mcer12/Ambien-ESP32/images/image2.jpg

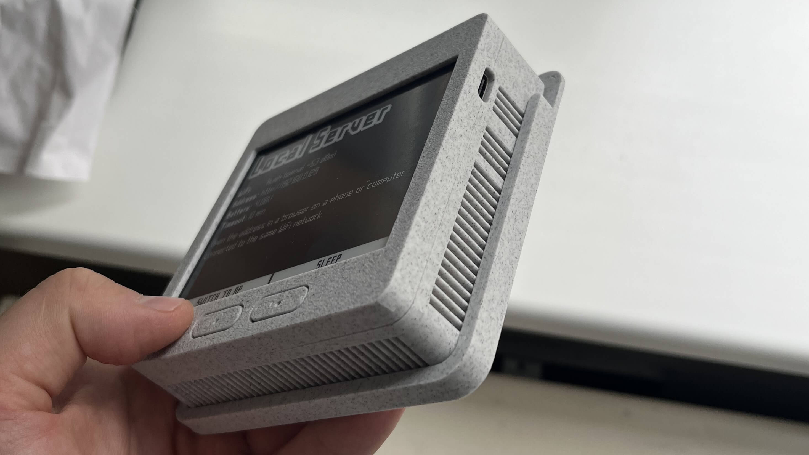
images/image2.jpg
