mcer12/Ambien-ESP32/images/portal_dark.png

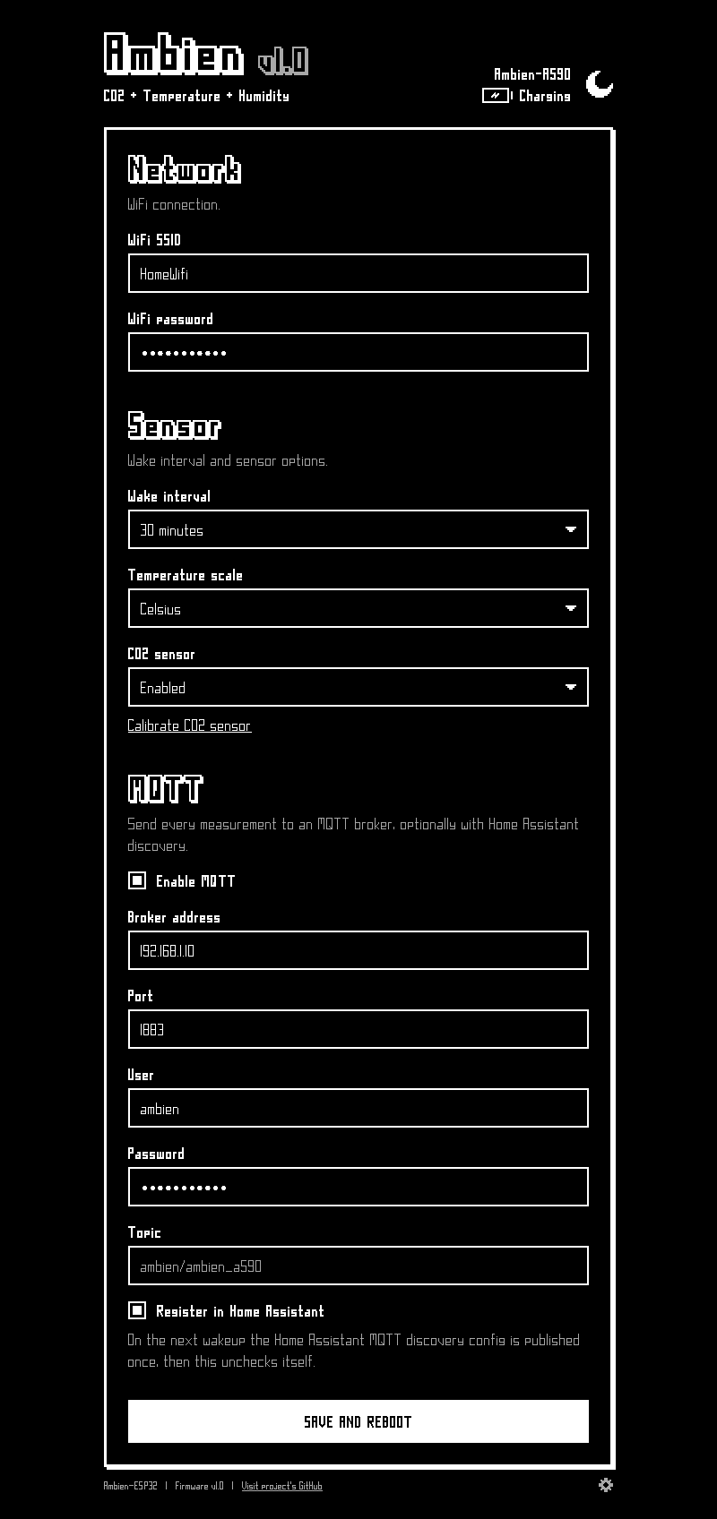
images/portal_dark.png
