mcer12/Ambien-ESP32/images/screen_ap.png

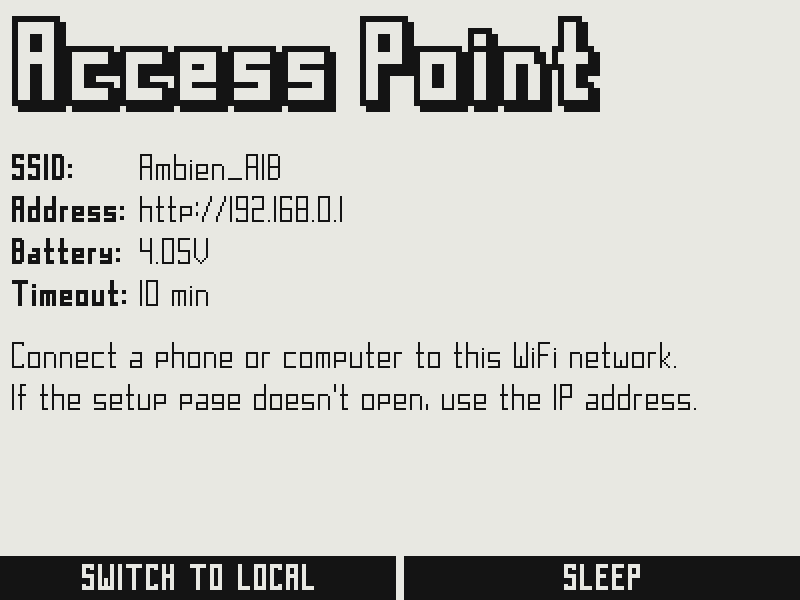
images/screen_ap.png
