mcer12/Ambien-ESP32/images/screen_no_co2.png

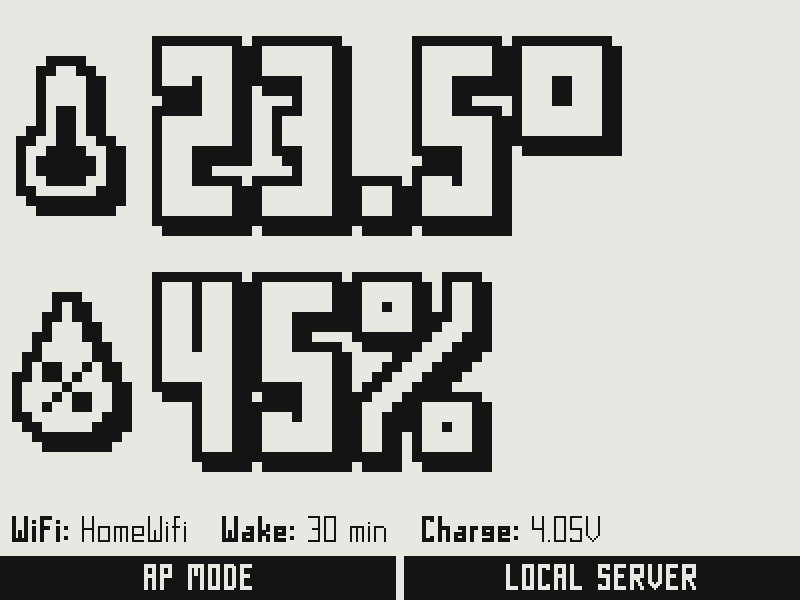
images/screen_no_co2.png
