mcer12/Ambien-ESP32/images/screen_sensors.png

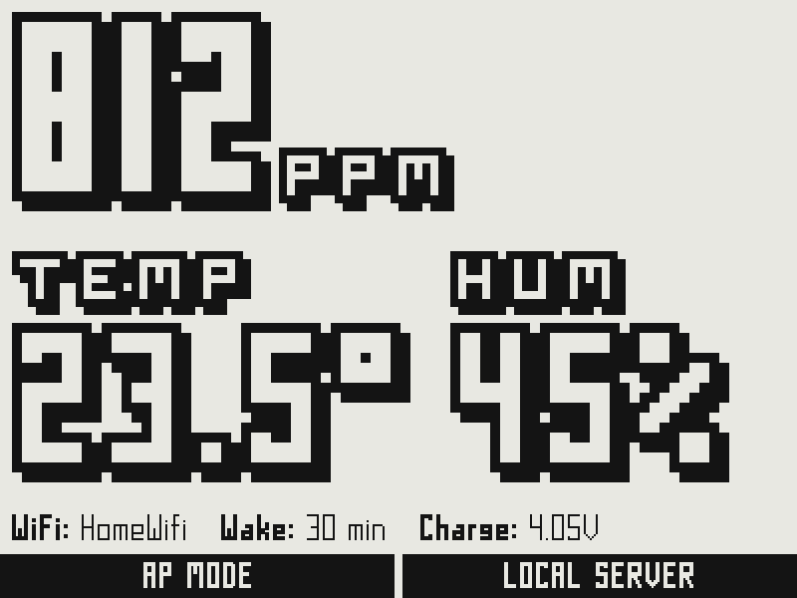
images/screen_sensors.png
