mcer12/Ambien-ESP32/pcb/Ambien_1.0_BOM.csv

ID | Name | Designator | Footprint | Quantity | Manufacturer Part | Manufacturer | Supplier | Supplier Part | Price
1 | KT-0603R | CHRG1 | LED0603-R-RD | 1 | KT-0603R | KENTO | LCSC | C2286 | 0.008
2 | 19-217/GHC-YR1S2/3T | FULL1 | LED0603-R-RD | 1 | 19-217/GHC-YR1S2/3T | EVERLIGHT | LCSC | C72043 | 0.024
3 | 680uF | C1 | CAP-SMD_BD6.3-L6.6-W6.6-LS7.2-FD | 1 | EEEFTJ681XAP | PANASONIC(松下) | LCSC | C178602 | 0.487
4 | 100nF | C19,C23,C5,C24,C25 | C0603 | 5 | CC0603KRX7R9BB104 | YAGEO(国巨) | LCSC | C14663 | 0.014
5 | 1uF | C2,C6,C7,C8,C9,C10,C11,C12,C13 | C0603 | 9 | CL10A105KB8NNNC | SAMSUNG(三星) | LCSC | C15849 | 0.016
6 | 4.7uF | C3 | C1206 | 1 | CS3216X7R475K500NRI | SAMWHA(三和) | LCSC | C513768 | 0.158
7 | 10uF | C4,C14,C15,C17,C18 | C0603 | 5 | CL10A106KP8NNNC | SAMSUNG(三星) | LCSC | C19702 | 0.031
8 | 5.1K | R1,R15 | R0603 | 2 | 0603WAF5101T5E | UNI-ROYAL(厚声) | LCSC | C23186 | 0.002
9 | 10K | R9,R3 | R0603 | 2 | 0603WAF1002T5E | UNI-ROYAL(厚声) | LCSC | C25804 | 0.005
10 | 6.8K | R10 | R0603 | 1 | 0603WAF6801T5E | UNI-ROYAL(厚声) | LCSC | C23212 | 0.002
11 | 2.2K | R12 | R0603 | 1 | 0603WAF2201T5E | UNI-ROYAL(厚声) | LCSC | C4190 | 0.002
12 | 1K | R13 | R0603 | 1 | 0603WAF1001T5E | UNI-ROYAL(厚声) | LCSC | C21190 | 0.002
13 | 1kΩ | R21 | R0603 | 1 | 0603WAF1001T5E | UNI-ROYAL(厚声) | LCSC | C21190 | 0.002
14 | 100Ω | R22 | R0603 | 1 | 0603WAF1000T5E | UNI-ROYAL(厚声) | LCSC | C22775 | 0.003
15 | 3 | R2 | R0603 | 1 | 0603WAF300KT5E | UNI-ROYAL(厚声) | LCSC | C23157 | 0.004
16 | 470uF | C20 | CASE-D_7343 | 1 | TAJD477K006RNJ | Kyocera AVX | LCSC | C7229 | 1.272
17 | BATTERY-18650 | BAT1,BAT2 | 18650_SMD | 2
18 | 1uF | C27,C28 | C0603 | 2 | CL10A106KP8NNNC | SAMSUNG | LCSC | C19702 | 0.031
19 | B5819WS | D1,D2,D3 | SOD-323_L1.8-W1.3-LS2.5-RD | 3 | B5819WS | MDD | LCSC | C64886 | 0.025
20 | SS34_C8678 | D4,D5 | DO-214AC_L4.3-W2.7-LS5.3-RD | 2 | SS34 | MDD | LCSC | C8678 | 0.035
21 | JFC0603-1100FS | F1,F2 | F0603 | 2 | JFC0603-1100FS | JDTFUSE | LCSC | C136329 | 0.066
22 | MF-PSMF110X-2 | F5 | F0805 | 1 | MF-PSMF110X-2 | BOURNS | LCSC | C89658 | 0.052
23 | AO3401A | F8 | SOT-23_L2.9-W1.3-P1.90-LS2.4-BR | 1 | AO3401A | AOS | LCSC | C15127 | 0.103
24 | AFC07-S24ECA-00 | FPC1 | FPC-SMD_AFC07-S24ECA-00 | 1 | AFC07-S24ECA-00 | JUSHUO | LCSC | C262643 | 0.134
25 | XC6206P332MR | LDO2 | SOT-23-3_L2.9-W1.6-P1.90-LS2.8-BR | 1 | XC6206P332MR | TOREX | LCSC | C5446 | 0.144
26 | SI1308EDL-T1-GE3 | Q2 | SOT-323_L2.0-W1.3-P1.30-LS2.1-BR | 1 | SI1308EDL-T1-GE3 | VISHAY(威世) | LCSC | C469327 | 0.29
27 | FS8205 | Q3 | SOT-23-6_L2.9-W1.6-P0.95-LS2.8-BR | 1 | FS8205 | FORTUNE | LCSC | C32254 | 0.183
28 | 10K | R4,R5 | R0603 | 2 | 0603WAF1002T5E | UniOhm | LCSC | C25804 | 0.005
29 | 1K | R6,R7 | R0603 | 2 | 0603WAF1001T5E | UniOhm | LCSC | C21190 | 0.002
30 | 10kΩ | R8,R11,R18,R19,R20 | R0603 | 5 | 0603WAF1002T5E | UniOhm | LCSC | C25804 | 0.005
31 | 680kΩ | R23,R24 | R0603 | 2 | 0603WAF6803T5E | UniOhm | LCSC | C25822 | 0.002
32 | MMBT3904-C20526 | T1,T2 | SOT-23-3_L2.9-W1.3-P1.90-LS2.4-BR | 2 | MMBT3904 | CJ | LCSC | C20526 | 0.012
33 | FS312F-G | U1 | SOT-23-6_L2.9-W1.6-P0.95-LS2.8-BR | 1 | FS312F-G | FORTUNE | LCSC | C82736 | 0.143
34 | SHT30-DIS-B | U2 | DFN-8_L2.5-W2.5-P0.50-BL-EP | 1 | SHT30-DIS-B | Sensirion | LCSC | C77361
35 | USBLC6-2SC6_C323793 | U4 | SOT-23-6_L2.9-W1.6-P0.95-LS2.8-BL | 1 | USBLC6-2SC6 | Yenji Elec | LCSC | C323793
36 | CH340C | U7 | SOP-16_L10.0-W3.9-P1.27-LS6.0-BL | 1 | CH340C | WCH | LCSC | C84681 | 0.548
37 | ESP-WROOM-32 | U8 | WIFIM-SMD_ESP-WROOM-32 | 1 | ESP-WROOM-32 | ESPRESSIF | LCSC | C95209
38 | USB3.1C16PFSMT | USBC1 | USB-C-SMD_TYPE-C-USB-17 | 1 | - | LCSC | LCSC | C167321 | 0.397
39 | 10uH | L1 | IND-SMD_L4.0-W4.0 | 1 | CR4030-100M | ceaiya(柯爱亚) | LCSC | C520323 | 0.048
40 | SCD40/SCD41 MODULE COPY | U5 | SCD40/SCD41 MODULE | 1
41 | HT7833_C164106 | U6 | SOT-23-5_L3.0-W1.7-P0.95-LS2.8-BR | 1 | HT7833 | Holtek Semicon | LCSC | C164106 | 0.34
42 | TP4059 | U3 | SOT-23-6_L2.9-W1.6-P0.95-LS2.8-BR | 1 | TP4059 | TOPPOWER(南京拓微) | LCSC | C80364 | 0.125
43 | pushbutton | B1,B2 | SW-SMD_L3.9-W3.0-P4.45 | 2 | TS-1088R-02026 | XUNPU | LCSC | C455280 | 0.056
