mcer12/Ambien-ESP32/enclosure/co2_top.3mf

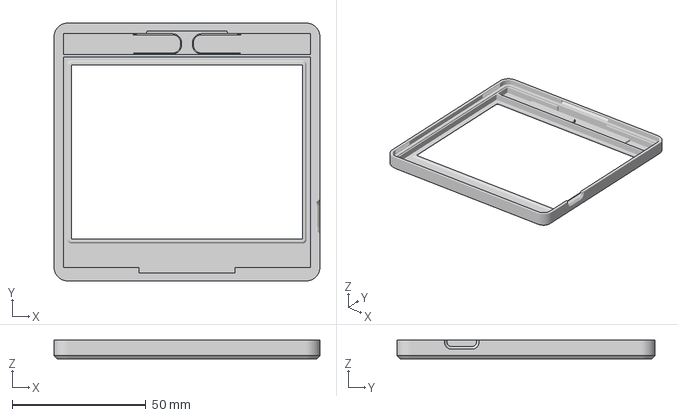
[picture p8: CAD file, 2026-10-29]
enclosure/co2_top.3mf
99.4 x 96.4 x 7.00 mm
