mcer12/Ambien-ESP32/enclosure/co2_holder.3mf

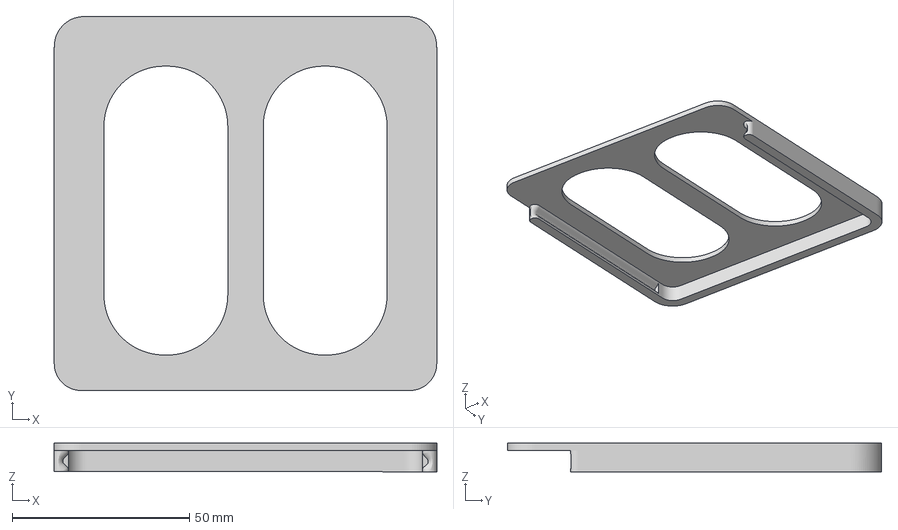
[picture p9: CAD file, 2026-10-29]
enclosure/co2_holder.3mf
107.8 x 105.4 x 8.03 mm
