mcer12/Ambien-ESP32/enclosure/co2_bottom.3mf

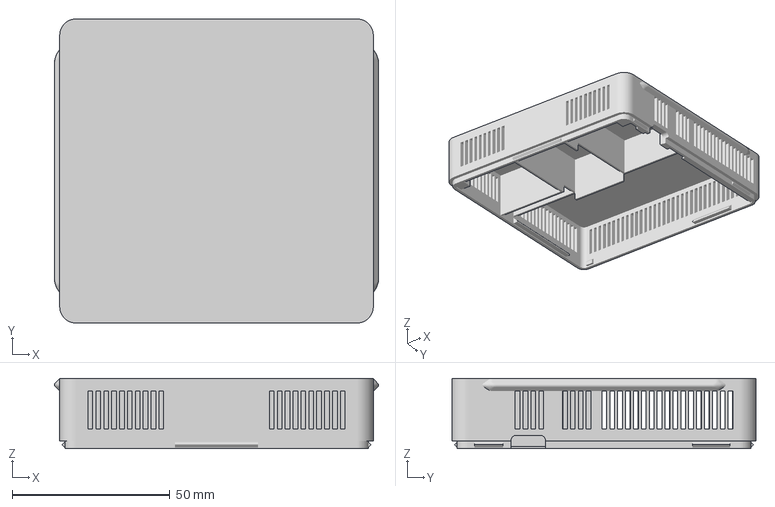
[picture p10: CAD file, 2026-10-29]
enclosure/co2_bottom.3mf
102.7 x 96.4 x 22.2 mm
