mcer12/Ambien-ESP32/(commit log)

2026-10-14 pcb source files, updated screenshots
    [Ambien_1.0_BOM.csv, Ambien_1.0_pickandplace.csv]
2026-10-27 - SCD40 calibration overhaul - Added dark mode functionality - Adjusted deep sleep logic to accommodate CO2 sensor warm-up requirements. - Server / eink display design tweaks
2026-10-29 3D models, images
    [co2_bottom.3mf, co2_holder.3mf, co2_top.3mf]
